knormoyle/rp2040_si5351_wspr/tracker/description.txt

//*******************************************
// Open source c/c++/arduino ide with arduino-pico core allows customization if you have software skills
// Especially useful for adding i2c/onewire sensors and sending results via u4b TELEN encoded telemetry.
// lu7aa website can be enabled to report those. no extra u4b channel reservation needed.

// No auto-calibration of Si5351 Tx frequency (yet?).
// Manual config for passing 'correction" (parts per billion) to Si5351, 
// in case Tx Frequency is outside of U4B channel bin.
// Traquito website can fingerprint callsign/telemetry frequency even if out of bin.
// LU7AA website not so well (although 'wide' helps).
// SDR can be used to report actual TX freq and correction applied to adjust.

// Any correction should be fixed: the same for all bands for a particular tracker.

// No auto-calibration of RP2040 clock frequency
// Manual config for setting rp2040 clock frequency, 115 to 250 Mhz. 115Mhz default
// (could calibrate/adjust with GPS PPS and then calibrate the Si5351 Tx frequency (signals go to RP2040 input)

// Uses unmodified AG6NS 0.4 pcb with alternate assembly bom/cpl (Manfuctured by https://jlcpcb.com)
// that:
// 1) removes low pass Tx filters, 
// 2) depopulates all APRS support on AG6NS 0.4 pcb (or firmware)
// 3) enables differential Tx drive for higher Tx power
// 4) capacitive coupling on Tx to both HF antenna legs, and lighter dc load across legs (larger R)
// 3) optionally populates the Bosch pressure sensor BMP280
// 4) uses the default LDO between solar power and 3V3. AG6NS board uses voltage monitor (resets)
// 5) User config menu over usb serial to config 
// 6) Configurable channel config, and bands 20M/17M/15M/12M/10M supported
// 7) Configurable U4B TELEN support for extra telemetry transmissions (temp/pressure from sensor, or sat counts or ...)
// 8) GPS is powered off during Si5351 Tx (external mosfet)
// 9) Si5351 is powered off during GPS acquistion/tracking (external mosfet)https://github.com/knormoyle/sf-hab_rp2040_picoballoon_tracker_pcb_gen1/blob/main/pcb/tracker/v0.4_kbn/corrected_placement_jlcpcb.png
// 10) clamping of speed/temp/voltage (3-4.95v) telemetry per traquito u4b-like definition.
// 11) compared to traquito: no buck/boost, just LDO. pressure/external temp sensor. Configurable extra telemetry. 
// 12) USB serial for config input and output. No need to modify software for callsign/band etc
// 13) Uses MS5351M instead of Si5351a.  Hans Summers G0UPL did a review here: https://qrp-labs.com/synth/ms5351m.html
// 14) Like traquito will clamp voltage/temp/altitude telemetry to lower/upper bounds. no wraparound. 
// 15) Voltage on tracker will be assumed to be 3.0-4.95 range. clamps to boundaries otherwise
// Optional) enable the 3rd output of si5351 during a calibrate cycle, and use FreqCount library to measure and report frequency.
//     Disable that output after reporting frequency. (one shot). I guess this would be the base HF freq for the band being enabled?
//     Is it just easier/better/more complete to do wspr RF and look on sdr?

/* key parts with jlpcb # (Cxxx)
C90770   ATGM336H-5N31  https://jlcpcb.com/partdetail/Zhongkewei-ATGM336H5N31/C90770  'GNSS Module'
C2040    RP2040         https://jlcpcb.com/partdetail/RaspberryPi-RP2040/C2040
C5446    XC6206P332MR-G https://jlcpcb.com/partdetail/TorexSemicon-XC6206P332MRG/C5446 '200mA Fixed 3.3V 6V Low Drop Out (LDO) Regulator'
C9965    MAX809STRG     https://jlcpcb.com/partdetail/Onsemi-MAX809STRG/C9965 '2.93v 140ms Active Low Supervisor and Reset'
C132296  26Mhz          https://jlcpcb.com/partdetail/KdsDaishinku-1XXB26000MAA/C132296 '1.8V~2.8V ±1.5ppm 26MHz 4P Temperature Compensated Crystal Oscillators (TCXO)' 

C83291   BMP280         https://jlcpcb.com/partdetail/BoschSensortec-BMP280/C83291 'Bosch Digital Pressure Sensor'
or
C92489   BME280         https://jlcpcb.com/partdetail/BoschSensortec-BME280/C92489 'Bosch Temp, Pressure, Humidity Sensor'
C2843335 W25Q16JVUXIQ   https://jlcpcb.com/partdetail/WinbondElec-W25Q16JVUXIQ/C2843335 '3V 16Mbit Serial Flash Memory w Dual/Quad SPI'

C1509083 MS5351M        https://jlcpcb.com/partdetail/Hangzhou_RuimengTech-MS5351M/C1509083 'I2C 200Mhz Clock Generator'
could use si5351a on same footprint

https://www.lcsc.com/datasheet/lcsc_datasheet_2404181014_Hangzhou-Ruimeng-Tech-MS5351M_C1509083.pdf
datasheet above is Mandarin 2023.11.24 11 pages
https://xonstorage.blob.core.windows.net/pdf/ruimeng_ms5351m_apr22_xonlink.pdf
datasheet above is Mandarin 2020.06.25 40 pages ..from http://www.relmon.com
short english datasheet 2021.03.08 10 pages
https://www.qrp-labs.com/images/synth/ms5351m.pdf
(does it draw 8mA more current?)
*/
//*******************************************
// coding style:
// although cpp features are used per arduino, strings are limited to char arrays like c
// google cpplint is used to flag style issues (follows google c++ style rules..
// some allowances like >80 chars/line)
// naming convention for functions/variables is loose/inconsistent 
// (underscore/camel case/capitalization etc)
// There is a single tracker.ino
// to avoid "one big blob" of code, multiple *_function.h and *_function.cpp are used to group
// logical groups of functions. Liberal use of globals, to minimize overall typing. 
// see externs in the *_functions.cpp
// All char arrays have null terminators on values, so they can be easily printed for debug or other.
// Flash is used to store configuration variables, to avoid recompiling firmware.
// config to control whether printf's can send to stdout and verbose levels to control amount of printing
// flight will generally be set to no output to stdout 
// Only the pwm for wspr send is interrupt driven. Careful management of when uart data from gps is unloaded

// recommended .vimrc (or equivalent)
// using tab on keyboard will translate to injecting <space> at 4 char boundaries
// right and left shift to same 4 char boundaries
// no <tab> in files
// .vimrc I use:
// set tabstop=4 softtabstop=0 expandtab shiftwidth=4 smarttab
// set noerrorbells visualbell t_vb=
// autocmd GUIEnter * set visualbell t_vb=
