knormoyle/rp2040_si5351_wspr/tracker/pcb/tracker/v0.4_kbn/gps.png

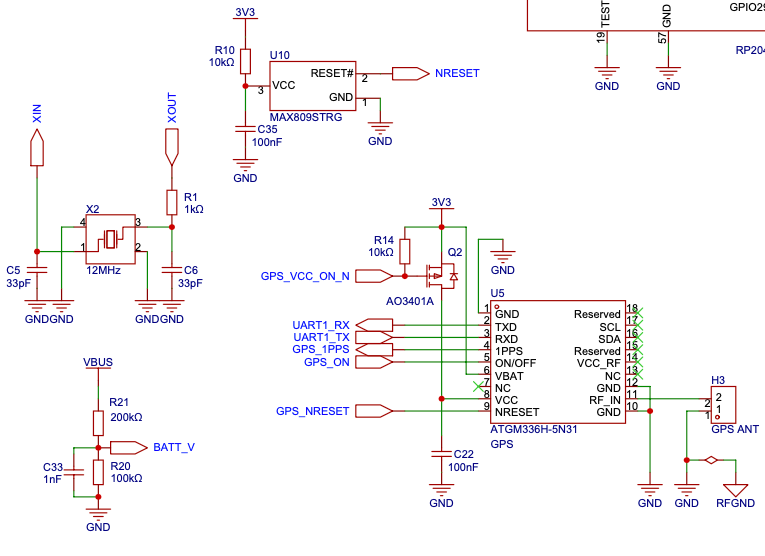
tracker/pcb/tracker/v0.4_kbn/gps.png
