knormoyle/rp2040_si5351_wspr/tracker/pcb/tracker/v0.4_kbn/BOM_Board1_PCB1_2023-09-11_atgm336h-5n31.xlsx

Comment | Designator | Footprint | JLCPCB Part #
22uF | C1 | C0805 | C45783
22uF | C2 | C0603 | C59461
100nF | C3,C4,C10,C11,C12,C13,C14,C15,C16,C17,C18,C19,C22,C23,C34,C35 | C0402_NEW | C1525
33pF | C5,C6 | C0402 | C1562
2.2uF | C7,C8,C9,C26 | C0402 | C12530
1nF | C33 | C0402 | C1523
0Ω | L2,L4 | R0603 | C21189
100nF | L3,L5 | C0603 | C1591
GREEN | LED1 | LED0603-R-RD | C72043
AO3401A | Q1,Q2 | SOT-23_L2.9-W1.3-P1.90-LS2.4-BR | C15127
1kΩ | R1,R17 | R0402 | C11702
3.3kΩ | R2,R3 | R0402 | C25890
10kΩ | R10,R13,R14,R16 | R0402 | C25744
22 | R6,R7 | R0402 | C25092
200Ω | R8 | R0402 | C25087
22kΩ | R11,R12 | R0805 | C25626
6.8kΩ | R18 | R0402 | C25917
100kΩ | R20 | R0402 | C25741
200kΩ | R21 | R0402 | C25764
RP2040 | U1 | LQFN-56_L7.0-W7.0-P0.4-EP | C2040
W25Q16JVUXIQ | U2 | USON-8_L3.0-W2.0-P0.50-BL-EP | C2843335
3.3V LDO | U3 | SOT-23-3_L2.9-W1.6-P1.90-LS2.8-BR | C5446
MS5351M | U4 | MSOP-10_L3.0-W3.0-P0.50-LS5.0-BL | C1509083
ATGM336H-5N31 | U5 | GPSM-SMD_ATGM336H-TR | C90770
MAX809STRG | U10 | SOT-23-3_L2.9-W1.6-P1.90-LS2.8-BR | C9965
Micro-USB Connector | USB1 | MICRO-USB-SMD_10118194-0001LF | C132563
26MHz | X1 | OSC-SMD_4P-L2.5-W2.0-BL | C132296
12MHz | X2 | OSC-SMD_4P-L3.2-W2.5-BL | C9002
