knormoyle/rp2040_si5351_wspr/(list of files, drawings)

Other design files:
tracker/pcb/tracker/v0.4_kbn/AG6NS_PicoBalloon_RP2040_v0.4.eprj
