knormoyle/rp2040_si5351_wspr/tracker/cw_functions.cpp

// Project: https://github.com/knormoyle/rp2040_si5351_wspr
// Distributed with MIT License: http://www.opensource.org/licenses/mit-license.php
// Author/Gather: Kevin Normoyle AD6Z initially 11/2024
// See acknowledgements.txt for the lengthy list of contributions/dependencies.

// forked from https://github.com/prt459/Nano_Beacon/tree/main
// Nano_Beacon 29 Nov 2021 by Paul VK3HN.

// Nano_Beacon -- a basic CW beacon
// See READ.ME at url above for further background and code mod help.
// https://vk3hn.wordpress.com/

// reverse beacon network 10M
// https://www.reversebeacon.net/main.php?zoom=33.57,-97.40,3.05&rows=100&spotters=1&max_age=30,days&bands=10&spotted_call=EA1KT&hide=distance_km

// EA1KT being spotted at 28022.0

// https://groups.io/g/picoballoon/message/19326

#include <stdint.h>

// NOTE! the clock disable mode doesn't work for keying the clk0/1 (ms5351m) ??
// set in tracker.ino
extern bool USE_SI5351A_CLK_POWERDOWN_MODE;

// always integers
const uint8_t DEFAULT_WPM = 12;
uint8_t target_wpm;
uint32_t dit_ms;

const bool DO_WPM_CORRECTION = false;
// this was tested with default 18Mhz sys clk
// actual/target wpm for an unadjusted PARIS 3x test
// shuldn't need correction!
const float DIT_MS_MULTIPLIER = 1.0;

enum test_msg  {
    SEND_PARIS3X = 0,
    SEND_DIT,
    SEND_DIT5,
    SEND_DASH,
    SEND_DASH5,
    SEND_DITDASH,
    SEND_DASHDIT,
    SEND_DASHDIT4,
    SEND_LONGCHAR,
    SEND_BALLOON,
    // SEND_TEST_CYCLE must be last enum
    SEND_TEST_CYCLE
};

// for balloon flight!
const uint8_t test_to_do = SEND_BALLOON;
// for ground level test!
// const uint8_t test_to_do = SEND_TEST_CYCLE;

//********************************
// we the full differential clk0/clk1 set with this
#define CW_CLK_NUM WSPR_TX_CLK_0_NUM

// https://morsecode.world/international/timing.html
#define CW_DAH_LEN 3
#define CW_LETTER_SPACE_LEN 3
#define CW_WORD_SPACE_LEN 7

// number of morse chars on Serial after which we newline
#define SERIAL_LINE_WIDTH 80

// is timing too inaccurate if using sleep (sometimes)
// swith to using the busy_wait_ms
// #define KEYING_DELAY sleep_ms
#define KEYING_DELAY busy_wait_ms

//******************************************
// from hans
// https://groups.io/g/picoballoon/message/19324
// Yet ANOTHER way to do this (CW) is possible, and works without the PLL Reset.
// Register 3 Output Enable Control contains a set of bits, when set to 1,
// it disables the corresponding output.

// So I have discovered that I can key CW by setting these bits to
// 1 for key-up (no output) or 0 for key-down (has output).
// When the output is disabled, it still preserves the proper phase relationship.
// So you can key the CW transmitter WITHOUT those few milliseconds of mess 
// at key-down ..a millisecond or two of the outputs not being both on and
// and not with the correct phase relationship,
// then 1.46 milliseconds of delay while the PLL Reset does its stuff
// PLL reset duration may vary, based on other s5351a config. 

// There are TWO ways to key a clock output on/off:
// Use the "power down" bit in the CLK0 Control and/or CLK1 Control registers
// (16 and 17 respectively).
// This does NOT preserve the inverted (180-degree) phase relationship
// when you re-enable by setting the power down bit to 0;
// hence a PLL Reset is required,

// If you want differential antenna drive (U4B High Power mode).
// Use the Register 3 "Output Enable Control" documented in AN619 at page 17
// https://www.skyworksinc.com/-/media/Skyworks/SL/documents/public/application-notes/AN619.pdf
// This DOES preserve the phase relationships so no PLL reset is required
// when using differential drive.

// OK, official.
// You DO need the PLL Reset, when using the PDN powerdown bit to turn on clk,
// to get the correct 180-degree phase difference,
// even when just using the inverted bit for phase difference.

// Tested using a little U4B BASIC program, and two-channel oscilloscope probes
// attached to each of Clk0 and Clk1 outputs.
// HP set to 1 to cause the inverted drive (high power) mode:
// withPLLReset.png: the standard U4B protection firmware version.
// There is a PLL reset (register 177) after switching on the clock outputs
// via their respective CLK0 Control and CLK1 Control regs: 16 and 17.
// Clk0 and Clk1 have the proper 180-degree phase relationship.

// After commenting out that line of code with the PLL reset,
// I see a random phase relationship between Clk0 and Clk1 on each keydown.
//******************************************

#include <Arduino.h>
#include <Adafruit_SleepyDog.h>  // https://github.com/adafruit/Adafruit_SleepyDog
#include "si5351_functions.h"
#include "print_functions.h"
#include "debug_functions.h"
#include "led_functions.h"
#include "gps_functions.h"
#include "cw_functions.h"
#include "global_structs.h"

//********************************
extern uint32_t XMIT_FREQUENCY;
extern bool VERBY[10];
extern uint32_t PLL_SYS_MHZ;

extern TeleStruct tt;
extern ConfigStruct cc;

// can be 0 1 2 or 3
// should I modify power using these
extern uint8_t SOLAR_SI5351_TX_POWER;

//********************************
// stay in first 91 khz of each cw band for rbn?
// alright if the generated frequency is not exact.
// use whatever denom we have setup for wspr
uint32_t get_cw_freq(char *band) {
    uint32_t cw_freq;
    switch (atoi(band)) {
        case 2:  cw_freq = 144100000; break;
        case 10: cw_freq = 28050100; break;
        case 12: cw_freq = 24935100; break;
        case 15: cw_freq = 21050100; break;
        case 17: cw_freq = 18150100; break;
        case 20: cw_freq = 14050100; break;
        default: cw_freq = 28050100; break;
    }
    V1_printf("get_cw_freq band %s will use cw_freq %lu" EOL, band, cw_freq);
    return cw_freq;
}

//********************************
// morse reference table
struct morse_char_t {
    char ch[7];
};
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
