knormoyle/rp2040_si5351_wspr/(commit log)

2024-11-07 first Arduino IDE 2.3.3 compile success with https://github.com/earlephilhower/arduino-pico core for board manager, using Raspberry Pi Pico board with minimal change for compile (will fully remove AP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
2024-11-07 try moving stuff to gps_functions.h and functions.c from LightAPRS-W-2-pico-balloon.ino
2024-11-08 added led_functions.h led_functions.cpp
2024-11-08 making progress with led_functions* si5351_functions* and had to modify library TinyGPS++.h for public access (see HACK)
2024-11-08 Adafruit sensorr
2024-11-10 correction and tx_high config state
    [config_functions.cpp, gps_functions.cpp, si5351_functions.cpp, tracker.ino, u4b_functions.cpp]
2024-11-11 got rid of telemetry_buff, replaced by individually named strings t_*, holding the captured (all at once) data
    [gps_functions.cpp, mh_functions.cpp, mh_functions.h, tele_functions.cpp, tele_functions.h, tracker.ino, u4b_functions.cpp]
2024-11-12 rearranged description/acknowledgements. added comments about move to bme280 (temp/humidity/pressure)
2024-11-13 working thru compile errors
    [bmp_functions.cpp, config_functions.cpp, debug_functions.cpp, gps_functions.cpp, mh_functions.cpp, si5351_functions.cpp, tele_functions.cpp, tracker.ino]
2024-11-16 gps. not sure if will use the analog correction stuff for adc?
    [adc_functions.cpp, adc_functions.h, gps_functions.cpp, gps_functions.h, tele_functions.cpp, tracker.ino]
2024-11-18 moved Serial.available() handling into core(). none in core1() run at 19200 baud to be able to have shorter duration gps data grab (now 418 ms including extra glonass GLGSV data) can't turn off GNZDA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
    [gps_functions.cpp, tracker.ino]
2024-11-18 nulls in some of the config strings..didn't trigger default settings
    [config_functions.cpp, gps_functions.cpp, tracker.ino]
2024-11-18 get rid of printFLASH use
2024-11-18 no printFLASH fixed t_* prints in tracker.ino
    [config_functions.cpp, tele_functions.cpp, tracker.ino]
2024-11-18 wspr batt voltage compare
2024-11-18 vfo on and i2cReadTest with 'Z'
2024-11-18 latest disabled i2c and si5351 library test
2024-11-20 bus scan. start to read/write i2c. have to fix reads to be write/read for si5351?
    [bmp_functions.cpp, bus_scan.ino, config_functions.cpp, i2c_test.ino]
2024-11-23 intermediate ..use of more stringent 3d fix valid and stuff for pwm timer for wspr delays (single interrupt
    [si5351_functions.cpp, tracker.ino]
2024-11-23 why not getting fix valid for long time. was vfo on?
    [gps_functions.cpp, si5351_functions.cpp, tracker.ino, wspr_functions.cpp]
2024-11-24 make the div and wrap cnt more generic and INTERRUPTS_PER_SYMBOL = 8 now use the new div and wrap values for 125 mhz (assumed clock)
2024-11-24 some tweaks to resetting all gps state and watchdogging for a full 3d fix, not just 2d fix
    [config_functions.cpp, gps_functions.cpp, gps_functions.h, tracker.ino, wspr_functions.cpp, wspr_functions.h]
2024-11-24 getting telemetry. callsign message isn't showing working on seeding the i2c writes before first symbol with clk0/clk1 turned off, then on
2024-11-24 align to two symbol interrupts before the first callsign tx
2024-11-24 why does KE6RAD work but not AD6Z (no sdr print) why does py encode.py AD6Z DM68 13 and py encode.py 'AD6Z ' DM68 1 give different symbol encodings
2024-12-06 Clean up compiler warnings that appeared after use of the V0_print* V1_print* defines interesting the cpp.o and cpp.d files are cached..have to delete them to see the warnings again (since compile is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
    [bmp_functions.cpp, config_functions.cpp, gps_functions.cpp, i2c_functions.cpp, si5351_functions.cpp, tracker.ino, wspr_functions.cpp]
2024-12-06 trying some experimental gps power on sequences (vcc, on/off pins) to see if power on current spike changes
2024-12-06 playing with GPS ON/OFF = off during poweron
2024-12-06 light sleep for 60 secs after gps cold reset. don't wait for proceed for first ssymbol if PLL_SYS_MHZ < 125 (was getting DT 0.7 ?)
    [gps_functions.cpp, tracker.ino]
2024-12-07 playing with some DRASTIC measures in gps_functions.cpp..lowering rp2040 to 18Mhlowering core voltage, shutting usb off (and restoring)..to try to lower power during initial gps cold reset
    [gps_functions.cpp, tracker.ino]
2024-12-07 have a DRASTIC_MODE bool to disable the aggressive power saving stuff at first g ps power on. default. something has gone wonky?
2024-12-07 unwonked it. back to playing with LOWEST_POWER_TURN_ON_MODE. can we really reduce it by 10mA ? bool EXPERIMENTAL_WARM_POWER_ON = true; bool EXPERIMENTAL_COLD_POWER_ON = true; bool LOWEST_POWER_TURN_O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
2024-12-07 IGNORE_KEYBOARD_CHARS global to make sure keyboard activity doesn't interrupt the transitions during the extreme power control during gps cold reset
    [config_functions.cpp, gps_functions.cpp, tracker.ino]
2024-12-07 don't turn on gps on/off unti we're in the lowest power rp2040 (gps cold reset "LOWEST_POWER" mode
    [gps_functions.cpp, tracker.ino]
2024-12-07 gps cleanup (cold reset) restored to 48mhz okay now
    [gps_functions.cpp]
2024-12-07 can't seem to deinit the usb pll without crashing
    [gps_functions.cpp]
2024-12-07 writing GPS config now with my config ..no broadcast at gps power on, also. (keep 9600 baud always now?) also removed core voltage changes..intermittent not coming back? not sure why bool ALLOW_UPDAT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
2024-12-07 change bool ALLOW_UPDATE_GPS_FLASH_MODE = false; so no gps config flash is updated to the no broadcast state. Will have to see if it's worth it Getting peak Iin (total power in) around 80mA @ 3.3v no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
    [gps_functions.cpp]
2024-12-09 18Mhz seems to working for K clock frequency (pll sys), gps nmea okay. kazu slow 12mh clock is working, but disabled right now. wasn't getting gps nmea correctly afterwards
    [config_functions.cpp, gps_functions.cpp, gps_functions.h, tracker.ino]
2024-12-09 12 mhz during gps cold reset, then pll back on to 18Mhz (couldn't get gps serial2 working with 12 mhz XOSC setup. 9600 baud. issues with 4800, but that works. probably needs some tweaking (gps hot re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
    [config_functions.cpp, gps_functions.cpp, tracker.ino, wspr_functions.cpp]
2024-12-09 still problem with non-usb BALLOON_MODE
    [config_functions.cpp, gps_functions.cpp, led_functions.cpp, tracker.ino]
2024-12-09 still some issues detecting serial and balloon mode (usb + data cable, or power only cable)
    [gps_functions.cpp, led_functions.cpp, print_functions.cpp, tracker.ino]
2024-12-09 eliminate garbage chars from Serial when no putty window, but usb data + power
2024-12-09 tried to detect usb connected status, in addition to looking at Serial. but the drain to cr/lf seems good too. seems to do wspr okay with usb cable (power + data) now? led blinking gives more info ab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
    [config_functions.cpp, tracker.ino]
2024-12-09 don't mess with peri/adc/rtc clocks any more during kazu slow mode. just leave them as they are.
2024-12-09 typo that should fix GLONASS constellation
    [gps_functions.cpp]
2024-12-09 enabled some VERBY[2] level microscopying of wspr symbol timing using StampPrintf and associated log print
2024-12-09 a little cleanup around use wsprSleepMillis() and hex printing of sieValue from SIE_STATUS (usb io mapped reg)
2024-12-10 ah. first time 10M works (on SDR). I had forgotten some hardwiring of a 20M freq I adjusted the code for deciding si5351a pll freq. hardwired it a little higher now ..700mhz. Maybe lower is good enou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
2024-12-11 print a 200hz swatch of test calcs for 10M band (for the pll stuff) trying to keep lower pll_freq...lower power?
2024-12-11 tweaking the target si5351a pll target, to get unique pll_num for 1hz sweep thru 200Hz wspr passband on 10M
2024-12-12 tuned nmea buffer overflow messaging (shorter) ..hmm. why was this showing up on 24Mhz?
    [gps_functions.cpp]
2024-12-12 reg 187 (fanout enables) doesn't exist in the 0.95 datasheet for si5351. Although it exists in some AN* pdfs for parts with more outputs. since we were never re-enabling it after disable, remove it (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
    [si5351_functions.cpp]
2024-12-12 board manager screenshot
2024-12-12 some more board screenshots for IDE
2024-12-14 check for illegal hf_grid. reboot on illegal hf_callsign/grid when creating hf_tx_buffer. was coming from TESTMODE issue. TESTMODE prints now (the telemetry sweep values)
    [si5351_functions.cpp, si5351_functions.h, tele_functions.cpp, tracker.ino]
2024-12-15 TESTMODE working better. no reboots
    [tele_functions.cpp]
2024-12-15 draining broken sentence quickly when entering NMEA unload, to avoid unnecessary buffer fifo overrun messages
    [gps_functions.cpp, si5351_functions.cpp]
2024-12-15 tweaking initial fifo management a bit more in updateGpsDataAndTime() to avoid unecessary messaging if close to full on entry
    [debug_functions.cpp, gps_functions.cpp]
2024-12-16 hacked in some public methods for flushing TinyGPS++ date/location state as part of invalidate during warm/cold reset..instead of trying to flip the object state (library modification)
    [gps_functions.cpp, tracker.ino]
2024-12-16 fixed the normal 10 minute scheduling. I had been using go_when_rdy=1 so much, I figured turning that off was simple!. Fixed. 10 minute normal works
    [tracker.ino]
2024-12-17 first working SIM65M. defaults to 115600 baud at startup. but this code changes to the 9600 baud like ATGM336H so we don't get buffer overflow at rp2040 (RTS/CTS hardware flow control not connected?)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
2024-12-18 hopefully this fixes the gps fix time stuff (reset on gps off -> on)
    [gps_functions.cpp, tracker.ino]
2024-12-19 having some random cross-core usage of the '_*' variables that are output from read_FLASH() tried setting them to voltatile (see comments) but _Band and _clock_speed have compile errors if volatile. 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
    [config_functions.cpp, config_functions.h, si5351_functions.cpp, tracker.ino, u4b_functions.cpp]
2024-12-19 don't quality the snapForTelemetry() behavior with fix validity all validity checking is in tracker.ino. avoids the blank issues?
    [tele_functions.cpp]
2024-12-19 made INTERRUPTS_PER_SYMBOL vary according to PLL_SYS_MHZ. only one interrupt per symbol for 18Mhz operation. The slow clock interrupt overhead maybe was messing with things and causing DT to be large?
2024-12-20 pwm the GpsPwr mosfet turnon, also use 2ma drive/slow slew rate on the GpsPwr pin not sure if perfect, seems to not have done any harm just affects gps cold reset
    [gps_functions.cpp]
2024-12-21 removed some of the old unused gps power on mode(s) code
2024-12-21 a little cleanup on the gps power on
2024-12-21 tweaking the gps pwm power on duty cycle management
2024-12-22 renamed all the _x16 stuff to be _x128 to match the current 7 bit shift PLL_CALC_PRECISION
2024-12-23 calculate the actual pll freq and output freq correctly using doubles, after deciding what si5351a values to use
    [si5351_functions.cpp, si5351_functions.h, tracker.ino]
2024-12-25 have some target denoms for 20,17,15,12,10.. 17 was hardest..couldn't find anything. using max 104575 but getting reasonably small shift errors (2Hz absolute)
    [tracker.ino]
2024-12-25 got rid of excessive printing during denominator search algo
    [WSPRDenom-modified.xlsx]
2024-12-25 tweak the printing
2024-12-26 tweaking. separate pages in the xlsx for 10/12/15/17/20M ..2M seems impossible
    [WSPRDenom-modified.xlsx]
2024-12-26 700 mhz pll target, optimal denoms for 10/12/15/17/20M (from spreadsheet) seems good
    [WSPRDenom-modified.xlsx]
2024-12-26 some tweaks. latest spreadsheets with denom work
    [WSPRDenom.xlsx, hans_check.xlsx, wspr_calc_direct_shift.xlsx, wspr_calc_direct_shift_denom.xlsx, wspr_calc_direct_shift_lower_pll_range.xlsx]
2024-12-27 fixing crash in BALLON_MODE. pll_deinit(pll_usb) can't be done in BALLOON_MODE (no usb to start with ?)
    [gps_functions.cpp, tracker.ino]
2024-12-28 detailed cleanup. trying to see if <500 mhz pll target can be made to work
    [wspr_calc_direct_shift_lower_pll_range.xlsx]
2024-12-28 optimal denom for pll 500 (spreadsheet says good for 10/12/15/17/20M)
    [wspr_calc_direct_shift_lower_pll_range.xlsx]
2024-12-28 hmm seems like PLL 500Mhz is the lowest I can go and cover 10M for optimal denom unless I shift to hans denominator-shift method
    [wspr_calc_direct_shift_lower_pll_range.xlsx]
2024-12-29 got the denom-shift-by-1/2/3 with fixed numerator algo working with random search (python) seems to look good in spreadsheet for targeted 416mhz pll (actually gets 390 or so for 10M with good symbol 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
    [WSPRDenom-modified.xlsx]
2024-12-29 switch sim65m navigation mode from default fitness mode to normal mode. I doubt it has much effect, although they say fitness mode changes position better for slow <5m/sec movement?? weird.
2024-12-30 first try at trying to call for solar elevation from snapForTelemetry()
    [gps_functions.cpp, solar_functions.cpp, solar_functions.h, tele_functions.cpp, wspr_functions.cpp]
2024-12-30 get all the t_solar* data into normal snapped telemetry (for easy printing etc)
    [tele_functions.cpp, tracker.ino]
2024-12-30 some tweaks for the solar functions
    [WSPRDenom-modified.xlsx]
2024-12-31 left out short_solarfunctions.cpp ..and a typo
    [solar4_functions.cpp, tele_functions.cpp]
2024-12-31 keep doubles for all the solar elevation/azimuth/distance stuff everywhere chop it to 1 decimal of precision ofr elevation/azimuth in the snapForTelemtry t_* stuff
    standardize on print 7 digits of precision for lat/lon?
    [solar2_functions.cpp, solar2_functions.h, solar4_functions.cpp, solar4_functions.h, solar_functions.cpp, solar_functions.h, tele_functions.cpp, tracker.ino]
2024-12-31 tweaking the solar elevation algo printing
2024-12-31 matching up the posted groups.io t.cpp short_solarfunctions.cpp source files correctly, in case they change used with #include to be consistent for exchanging code with Doug
    [solar2_functions.cpp, solar4_functions.cpp, solar_functions.cpp]
2024-12-31 got rid of solar_functions.cpp and solar_functions.h because it wasn't accurate (code bug?) moved to other_cpp in case of future use. added all the other stuff in other_cpp that might be useful (if n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
    [gps_functions.cpp, solar_functions.cpp, solar_functions.h]
2025-01-01 fixed the config command to reboot to drag and drop uf2 (normally i use the ide to load firmware, but this is useful to avoid tweezer shorting the pcb holes (bootsel/gnd) if you need to force bootloa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
    [config_functions.cpp]
2025-01-01 tweaking some prints and the solar angle calculations (which is only used for info ..but is sent down using the speed field can be disabled (recompile) so normal gps speed is sent but should be inter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
2025-01-01 stop disabling usb pll when usb is connected. (gps cold reset power optimization)...sometimes not coming back (kazu clocks area)...make some more strings F()..chopped down the JTEncode.cpp to only su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
    [config_functions.cpp, debug_functions.cpp, gps_functions.cpp, i2c_functions.cpp, si5351_functions.cpp, solar2_functions.cpp, solar4_functions.cpp, tele_functions.cpp]
2025-01-01 turned the ALLOW_LOWER_CORE_VOLTAGE_MODE (0.95v) ..at 18mhz should be fine. looks like it saves 1mA ?
2025-01-02 first crack at the "morse_also" config that sends a morse cw message (callsign + grid6) after the wspr messages
    [config_functions.cpp, debug_functions.cpp, debug_functions.h, gps_functions.cpp, gps_functions.h, si5351_functions.cpp, si5351_functions.h, solar2_functions.cpp]
2025-01-02 something went wrong with gps summary printing
    [gps_functions.cpp]
2025-01-02 seem to have sorted out my gps stats print. using a 'realPrintFlush()' routine to gather info about usbserial tx buffer size etc.A Got solar5_functions.cpp in there. not printing from it yet (that's 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
2025-01-03 tweaks of realPrintFlush() and now printing from the suncalc algo
2025-01-03 some more printing stuff. didn't have bitwise inversion for the clk en stuff in si5351a_functions.cpp
    [config_functions.cpp, cw_functions.cpp, debug_functions.cpp, si5351_functions.cpp, solar4_functions.h, solar5_functions.cpp, tele_functions.cpp]
2025-01-03 cw with PDN power down bit to control clk0/1 instead of the clk enable bit
2025-01-03 perfect 12wpm timing with multiplier on dot timing from 'PARIS ' 3x timing actual vs target. Switched to my balloon message
2025-01-03 improved prints
2025-01-04 get rid of the ugly code in printInt/printStr/printFloat for gpsDebug by using variables in printf formats. works great. moved to debug_functions.cpp again, hopefully will work now (had removed equat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
2025-01-05 switch to normal balloon cw message
2025-01-05 working in a switch to the Farey algo search for new num/denom rather than fixed magic denom have to add a 4 symbol (hf_freq) cache to the calc routine so we don't iterate all the time in computing n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
    [debug_functions.cpp, farey_functions.cpp, farey_functions.h, gps_functions.cpp, si5351_functions.cpp, si5351_functions.h]
2025-01-06 moved the various sweep test functions into swee_functions.cpp..si5351a_functions.cpp was getting too big
    [sweep_functions.cpp, sweep_functions.h]
2025-01-06 disable the solar_functions.cpp stuff for now (wrong answers) solar2* and solar4* still active. solar5* is the suncalc..not working yet?
    [tele_functions.cpp]
2025-01-06 added a debug function to print the valid entries of the calc cache. will check for any 0s in valid entry also. run at end of every loop1(). should be 4 entries if just wspr. 5 entries if _morse_also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
2025-01-06 seemed to have messed up the si5351a programming. fix it tomorrow
    [si5351_functions.cpp, tracker.ino]
2025-01-06 back to the numerator shift algo but I think I might have figured out the issue with the Farey algo
    [si5351_functions.cpp]
2025-01-06 might be interesting to use arduinomorse to send diagnostic messaging with the leds for more involved messaging cp_libraries.sh is good for setting up libraries in the Arduino dir
2025-01-06 start wspr warmup 20 secs before the min, rather than 30, to account for a > 30 sec cw message. might help in less missed starts when send_when_rdy config is enabled. plus easier understanding for 40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
    [tracker.ino]
2025-01-06 images for putty sessions. some EOL cleanup in prints
2025-01-07 clean up some prints
2025-01-07 switched to uint64_t for freq_128 to allow a bigger PLL_CALC_SHIFT than 7, to improve precision and not lose bits Using a PLL_CALC_SHIFT of 16 with uint64_t and making sure the pll_remain doesn't los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
    [si5351_functions.cpp, si5351_functions.h, sweep_functions.cpp, tracker.ino]
2025-01-07 tweaks to printing
2025-01-07 switched back to 500 mhz pll
2025-01-07 weird issues with ms_div divide
    [si5351_functions.cpp, tracker.ino]
2025-01-08 I only had one function that returned uint64_t. I think occasionly it would just return the upper 32 bits?
    freq_xxx = calcSymbolFreq_xxx(xmit_freq, symbol);
    I just changed it to pass a pointer as the first arg instead. seems more reliable and not-unique-behavior
    Showed up when I was doing larger PLL_CALC_SHIFT values
    [WSPRDenom-modified.xlsx]
2025-01-08 400Mhz PLL, 10M band, 16 bit scaled-integer-shift. Does it relate to 52 bits of mantissa in the double real as input to Farey? seems like this works, with small enough error
    [config_functions.cpp, si5351_functions.cpp, sweep_functions.cpp, tracker.ino, u4b_functions.cpp, u4b_functions.h]
2025-01-08 New versions of libaries. Put the crystal capacitance back to 7pf seems better than default 10
2025-01-09 650Mhz pll target freq. got 618.7Mhz on 10M. very low errros symbolAbsoluteError: 0.000003 Hz symbolShiftError: 0.000006 Hz
2025-01-09 playing with pll freqs. Got rid of the wsjt-x 14MDA LR90 30 problem with wsjtx and symbol freq cycling during warmup
    [si5351_functions.cpp, si5351_functions.h, tracker.ino]
2025-01-09 back to 600Mhz. phase noise?
    [tracker.ino]
2025-01-10 changed the two libraries I modified to have *_mod suffix, so new updates to those libraries won't overwrite in ide. had a long debug trying to figure out why my num/denom was only changing two symbo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
    [cw_functions.cpp, gps_functions.cpp, si5351_functions.cpp, si5351_functions.h, tracker.ino]
2025-01-10 adding 2 as band option. Going to see if I Farey algo will work on 2M for wspr shift frequencies. Added separate band control for cw. had wspr alignment wrong for go_when_ready..was trying to have mo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
    [config_functions.cpp, cw_functions.cpp, si5351_functions.cpp, sweep_functions.cpp, tracker.ino, u4b_functions.cpp]
2025-01-10 put the bones in (configuration, detection, globals etc) for detection solar elevation maximums, earliest, afternoon, morning..configuration for adjusting tx power based on solar elevation (from gps 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
2025-01-10 updated prints on solar elevation transitions
2025-01-10 tweaks on the dynamic solar tx power tracking
2025-01-10 qualify the solar calcs with gps validity info, just in case
2025-01-11 dynamic solar tx power
2025-01-11 back the way it was (using pll reset on every freq change plus clk disable/enable
    [si5351_functions.cpp]
2025-01-12 make the PLL_FREQ_TARGET unique per band (to get lowest error or solution, like for 2M)
    [si5351_functions.cpp, si5351_functions.h, sweep_functions.cpp, tele_functions.cpp, tracker.ino]
2025-01-13 put ERROR: in the error messages when the config is validated, so they'll grep ERROR putty.log
    [config_functions.cpp, si5351_functions.cpp]
2025-01-17 Had broken the telemetry alignment relative to callsign when I was playing with some clock off stuff between wspr messages (currently don't turn clock off between wspr messages). The net effect was t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
    [tele_functions.cpp, tracker.ino]
2025-01-17 seems like if we use Farey we always need pll reset? otherwise some frequencies (2 out of 4) don't seem to work I had thought I could just look for cases where denom changes, but apparently that does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
    [si5351_functions.cpp]
2025-01-17 I got nervous the wspr symbols were sounding different. Changed the Z test to do the 4 symbol frequencies sequentially for 15 secs each, for easier listening changed the pll target freqs to 600. now 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
    [config_functions.cpp, si5351_functions.cpp, tracker.ino, wspr_functions.cpp]
2025-01-17 sounds cleaner with less pop on transitions, if use numerator shift algo. Apparently it works without pll reset on the numerator-only shift, so that's probably a good thing. (I'm pretty sure I needed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
    [si5351_functions.cpp]
2025-01-17 still trying to fully understand the clk disable/enable bit. Seems like the enable is required, but disable doesn't turn off the clock
    [si5351_functions.cpp, tracker.ino]
2025-01-17 still trying to fully understand the clk disable/enable bit. Seems like the enable is required, but disable doesn't turn off the cl ock. minimizing the amount of time I write the clk enable
    [tracker.ino]
2025-01-17 Made the GpsWarmReset() more closely parallel the behavior of GpsFullColdReset() ..mainly doing pwmGpsPwrOn() to pwm the mosfet gate turn on ..weird that it seemed like Dave had a failed gps warm pow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
    [gps_functions.cpp, si5351_functions.cpp]
2025-01-18 shorten the GpsWatchdogCnt limit before full cold reset some print tweaks
    [gps_functions.cpp, si5351_functions.cpp, tracker.ino]
2025-01-18 try to show any of the initial chars out of gps after reset. Probably should wait for some?
    [gps_functions.cpp]
2025-01-18 just noticed i had pasted comments from a javascript convert into the .cpp. put them in the right file instead. The xlsx were just background research stuff.
    [wspr_calc_direct_shift.xlsx, wspr_calc_direct_shift_lower_pll_range.xlsx]
2025-01-18 Did some cpplint on short_solarfunctions.cpp (the one used in-flight) and changed longs to uint64_t to be clear
    [solar4_functions.cpp, solar5_functions.cpp]
2025-01-19 tinygps_functions* stuff compiles now. Should just be printing right now. Haven't incorporated the Extended Telemetry tx'ing stuff yet
2025-01-20 first cut at encoding some extended telemetry. compiles
2025-01-21 added a gps warm reset loop test. seems okay
    [config_functions.cpp, config_functions.h, debug_functions.cpp, debug_functions.h, gps_functions.cpp, time_functions.cpp, time_functions.h, tinygps_functions.cpp]
2025-01-22 Make a one stop solar4Position() function, for other_cpp/short_solarfunctions.cpp
    [solar4_functions.cpp, tinygps_functions.cpp, tracker.ino]
2025-01-25 a subtle issue in putting Extended Telemetry into a string
    [doug_functions.cpp, doug_functions.h, si5351_functions.cpp, tele_functions.cpp, tracker.ino]
2025-01-27 report solarElevation*2 (so above 41 deg will flatline to 41 deg). also make both normal gps speed telemetry and solarElevation*2 round better, reflecting the steps of 2. (want to round to 2). some o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
2025-01-30 got rid of the pwm on the mosfet gate voltage for gps turn on (both warm and cold reset) could this have been getting Dave into a state where gps cold reset didn't recover from a failed gps warm rese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
    [gps_functions.cpp]
2025-01-30 Bill WB8ELK has provided some audio recordings of cw from AD6Z-23 flight near US/Mexico border using web sdrs. He thinks I'm losing some dits. Change from using sleep function for keying delays to th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
2025-02-03 remove overflow'ed field on extended telemetry. Fix slot 3 (not slot 4) for encode
    [config_functions.cpp, doug_functions.cpp, tracker.ino]
2025-02-04 change ET slot to 2, counts 0,1,2,3,4
2025-02-05 some tweaks to delays in gps warm/cold reset. added 868864 Feb 4 18:35 tracker.ino.uf2 can drag/drop this uf2 after shorting the bootsel/gnd thru holes while powered down, then power up
    [gps_functions.cpp]
2025-02-05 just clarifying some print comments
2025-02-05 make sure 1 sec between any Serial2.end() and another Serial2.begin() (rp2040 uart to gps)
2025-02-05 if the duration of updateGpsDataAndTime is too short (<100 ms) randomize the delay befor calling it again in sleepSeconds() we may just be discarding stuff each time, and never getting properly align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
    [gps_functions.cpp, gps_functions.h, tracker.ino]
2025-02-05 just a printing thing. make duration_millis print as 0 when no chars are received in the SIM65M case. I guess can show up with ATGM336H, but less common because broadcast rate is 1 sec, not 5 sec
2025-02-06 clean up a wrong print format, and get rid of a compiler warning
    [debug_functions.cpp, tracker.ino]
2025-02-06 another print format compiler warning fix
    [si5351_functions.cpp]
2025-02-07 get rid of the noprint stuff when getting data from gps chip look for positive affirmation of some chars ($ for nmea sentences) after gps warm reset and cold reset. retry up to 5 times if reset didn'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
    [gps_functions.cpp, gps_functions.h, tracker.ino]
2025-02-07 SIMCOM didn't document navigation modes 3 (balloon mode) or 5 (drone mode) apparently there may be a 10km altitude limit for all modes other than balloon mode, according to the locosys spec sheet for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
    [gps_functions.cpp]
2025-02-07 get rid of the unnecessary V1_flush() (usb serial print flush) in the gps data loop. no normal prints there
2025-02-08 allow lots of garbage chars while looking for the 2 '$' after a cold/warm reset..can be over 200! also, get rid of excessive warns about the chars in fifo during updateGpsDataAndTime...print warn on 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
    [gps_functions.cpp]
2025-02-08 print out the duration time (millis) for gps warm and cold reset (full duration) maybe we shouldn't redo as much configuration for gps warm reset, since it should be unnecessary? not clear there's a 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
    [gps_functions.cpp]
2025-02-09 Trying to get perfection for what chars are sent to TinyGPS, so no checksum errors. Needs to be two steps at first for fifo handling: 1) If the fifo is full, chars could have been lost. So the whole 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
    [gps_functions.cpp]
2025-02-09 clean up some print EOL stuff
2025-02-09 tweak some prints
2025-02-09 better way to handle the "aligned" step. always print (good for debug) but only send to TinyGps if we had gotten aligned. Fine to count chars while not aligned for statistics. And consume time elapse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
2025-02-09 insidious bug with JTEncode reported by KC3LBR. They walk 0-12 in the callsign char array. So I declare it size 14 to accomodate null term. And use snprintf with %-s to pad on right with spaces (hf_c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
    [doug_functions.cpp, gps_functions.cpp, tracker.ino, u4b_functions.cpp]
2025-02-09 oops. subtle bug where I used sizeof() when I shouldn't have with snprintf (telemetry)
    [u4b_functions.cpp]
2025-02-09 Don't reconfigure gps during warm reset unnecessarily. speeds up gps warm reset takes 17.6 secs now on SIM65M. Probably could tweak some more, but this is good probably a little faster on ATGM336H.
    [gps_functions.cpp]
2025-02-10 for SIM65M only, we had reduced the NMEA broadcast to once per 5 secs to try to save power. To make sure we align to get full burst, change the GPS_WAIT_FOR_NMEA_BURST_MAX to 5500 millis (config_func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
2025-02-10 allow update of rtc time (setTime()) as long as the gps.time.age() (fix_age) is no bigger than 500ms used to constrain to 300 ms, but because of the bursting of NMEA sentences, we could have fewer op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
    [gps_functions.cpp]
2025-02-10 overhaul setting time from gps. Move the time update as close as possible to when the time NMEA sentence arrives. Only update time if needed, every 30 secs, print messages showing system time and gps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
    [debug_functions.cpp, gps_functions.cpp, gps_functions.h]
2025-02-11 updated secondDelta drift count to deal with minute transitions, hour transitions, day transitions. so there will be an inaccurate print possible with month or year transitions but that's okay ..not 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
    [debug_functions.cpp, gps_functions.cpp]
2025-02-11 fix a couple things with the secondDelta reporting. also it won't report on the first set, so there won't be any false ERROR prints
    [config_functions.cpp, cw_functions.cpp, debug_functions.cpp, gps_functions.cpp, gps_functions.h, tracker.ino]
2025-02-12 I think I went back to not doing the 1 sec step. SDR prints look good with this (less than 1.0)
2025-02-12 add files for pcb
    [AG6NS_PicoBalloon_RP2040_v0.4.eprj, BOM_Board1_PCB1_2023-09-11.xlsx, BOM_Board1_PCB1_2023-09-11_atgm336h-5n31.xlsx, BOM_Board1_PCB1_2023-09-11_kbn.xlsx, BOM_Board1_PCB1_2023-09-11_kbn2.xlsx, BOM_Board1_PCB1_2023-09-11_kbn3.xlsx, BOM_Board1_PCB1_2023-09-11_sim65.xlsx, PickAndPlace_PCB1_2023-09-11.xlsx]
2025-02-12 overnight run with ATGM336H and gps-only sats, had no ERRORs on time drift or other errors. Switching back to gps+beidou+glonass to see if maybe glonass is causing time sync issues?
    [gps_functions.cpp]
2025-02-13 increase the "quiet" time after a gps time update to 3x the nmea burst interval waiting period. no need to have back to back updates. Is it causing a problem somehow?
    [gps_functions.cpp]
2025-02-13 Doing a little trick in the Time library to compensate for the latency in getting gps nmea sentence for time...it should be relatively constant delay, so a fixed offset to help align system time and 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
    [gps_functions.cpp]
2025-02-13 added new config for changing the constellation group used (valid combos from 1 to 7. 7 is gps+bdu+glo. 3 is gps+bud. 1 is gps only. Wondering whether glonass is messing up time sync. Also, I hadn't 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
    [config_functions.cpp, cw_functions.cpp, debug_functions.cpp, global_structs.h, gps_functions.cpp, gps_functions.h, tele_functions.cpp, tinygps_functions.cpp]
2025-02-13 mostly lint and adjusting of various print messages, tuning the forceUpdate (gps to system time) condition
2025-02-13 create simple pps rise detection (irq) to log when the edge happens with millis() ..then we can report the skew from the aligned 1 sec interval in gps chip to when we decide to setTime() and see if i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
2025-02-14 changed Time library to Time_mod because I had editted it a lot remember to remove link or copy of Time library in Arduino libries if you're compiling and create new link to Time_mod. A git pull will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
2025-02-15 have fastest possible reaction to GNGGA now (have to wait for checksum/time commit) and adjusted *EXTRA* millis to align to 1-sec-in..result looks like DT==0 for ATGM336H and SIM65M
2025-02-15 some reporting on the micros() and millis() durations for PPS edge to edge timeing, to check rp2040 timing accuracy relative to PPS transitions.
2025-02-15 tweaks to PPS related info printing. Try to disable when it's none GPS has been off for a while..so PPS isn't available or stable.
2025-02-15 remove excessive edge to edge interrupt printing (can break up other print lines)
2025-02-16 put in 200 prints of per sec usecs() count (using PPS) ..interesting to see how fast or slow per second
2025-02-16 typo: printed should be static int
2025-02-17 print update
2025-02-17 if I decide the gps date/time is 'bad' ..still use it on forceUpdate (just in case my determination was wrong)
    [gps_functions.cpp, tracker.ino]
2025-02-17 tweaks and print updates
2025-02-18 I guess the PPS config for SIM65M is good with the default...don't need to program during gps warm/cold reset
    [gps_functions.cpp, pps_functions.cpp]
2025-02-18 Using PPS is tricky since it takes time to stabilize for accuracy and we're turning gps power on/off when we wspr tx. count PPS transitions when PPS is enabled (gps on)...wait for 30 PPS transitions 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
    [gps_functions.cpp, pps_functions.cpp, pps_functions.h, tracker.ino]
2025-02-18 update with setTime() every valid time, not just if gps/system time disagree. to align with millis() ..should only happen once per nmea burst, max (1 per sec)
2025-02-20 decided to not ever use the GGA time if it has thousandths. the PPS skew tends to be high. better to wait til we get a fix and thousandths is 0 (same every 1 sec broadcast)
    [gps_functions.cpp]
2025-02-24 added support for BMP280 pressure/temperature/altitude reads, with Extended Telemetry for pressure configurable using 'T' (can be sent after the sat count Extended Telemetry or instead of.
2025-02-24 Have to get rid of Galileo sats for SIM65M. Just too much characters at 9600 baud to complete in < 1sec. Also got rip of GNGSA (active sats). When 4 constellations report there are 4 GNGSA sentences.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
    [doug_functions.cpp, gps_functions.cpp]
2025-04-26 was seeing some altitude=0 tx for the ATGM336H flight AD6Z-26. don't update tt.altitude if altitude = 0 (not sure why that would occur). Added tinygps flush methods for altitude and speed. and use al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
    [debug_functions.cpp, gps_functions.cpp, tele_functions.cpp, tracker.ino]
2025-04-30 get rid of unnecessary bom/place files. update atgm336h file to 180 rotation for U5 gps chip
    [BOM_Board1_PCB1_2023-09-11.xlsx, BOM_Board1_PCB1_2023-09-11_kbn.xlsx, BOM_Board1_PCB1_2023-09-11_kbn2.xlsx, BOM_Board1_PCB1_2023-09-11_kbn3.xlsx, PickAndPlace_PCB1_2023-09-11.xlsx, PickAndPlace_PCB1_2023-09-11_atgm336h-5n31.xlsx, PickAndPlace_PCB1_2023-09-11_kbn.xlsx, PickAndPlace_PCB1_2023-09-11_kbn2.xlsx]
2025-05-01 just current uf2
2025-05-04 change factory reset constellation group to 3 (GPS+Beidou)
    [config_functions.cpp]
2025-06-24 some change to defines for si5351 regs. fix compile problem on the grid4 in cw message
    [cw_functions.cpp, si5351_functions.cpp, si5351_functions.h, tracker.ino]
2025-06-24 adjust base freq target -15 hz to do better job centering in 10m bins
2025-07-11 stupid SIM65M-CB parts I got instead of SIM65M are Beidou only and can only do 1115200 baud (can't slow down to 9600) ..get rx fifo overflow. SIM65M-CB spec is only available at cn.simcom.com ..not o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
2025-07-15 added WsprEncoded from knormoyle github. Should be 4.3.2 as it was the 4.3.2 arduino library manager version
2025-09-01 had problem with factory reset on a new batch of sim65m boards. added the safe_execute back in when erase/write flash
    [config_functions.cpp, si5351_functions.cpp]
2026-03-08 added changes for 6m band support also got rid of a Serial.End() that seemed to abort things now with new ide? will have to see if ALLOW_USB_DISABLE_MODE might work during test didn't test with sdr y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
    [wspr_calc_direct_shift.xlsx]
2026-03-23 make Y and W commands using the normal gps cold reset and gps warm reset in a loop for testing update the gps debug print to include FixMode and FixQuality from TinyGPS++ -- Sats HDOP Latitude Longit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
    I should probably include FixMode and FixQuality in the big "valid fix" "fix_valid_all =" statement that's in a couple of places
    To make sure it's a valid 3d fix? right now I look for sats 3 more (used)
    Should probably add the HDOP, PDOP, VDOP and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
    [config_functions.cpp, config_functions.h, debug_functions.cpp, debug_functions.h, gps_functions.cpp, tracker.ino]
2026-03-26 i'm really doing gps hot start with backup power. changed warm names to hot. added test for 'H' gps hot reset. 'W' currently does hot reset. no real warm reset, except when hot doesn't get sentences 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
    [config_functions.cpp, gps_functions.cpp, gps_functions.h, tracker.ino]
2026-03-26 change the fix detection on the gps test loops (not the main tracker.ino (yet) ..to look for 5 or more sats used, to see effect on accuracy (variance)
    [debug_functions.cpp]
2026-03-30 changed default config to constellation group 7 (BDS + GPS + GLS) add FixMode and FixQual strings to the snapForTelemetry. not used yet for anything other than print
    [config_functions.cpp, global_structs.h, gps_functions.cpp, tele_functions.cpp, tracker.ino]
2026-04-29 updated TinyGPS to detect single constellation BD sentences_ add more gpsDebug prints during gps test loop some code optimization in gps_functions.cpp and change ATGM366 broadcast rate to 5secs (mayb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
    [config_functions.cpp, debug_functions.cpp, gps_functions.cpp, tele_functions.cpp, tinygps_functions.cpp, tracker.ino]
2026-04-30 updated kazuClocksSlow and kazuClocksRestore so we can be in 12mhz while bringing gps chip up (power spike?) assumes we are 18mhz (or more) before and after that
2026-04-30 cleaned up voltage reduce/restore during slow_clock_functions power reduce while gps turns on will leave it running at 0.95v (if allowed) if 18Mhz.
2026-04-30 had some problems with flash erase code. Also changed flash offset to allow for larger program. Will have to redo all config in flash some tweaks to setting gps baud rate for sim65m/atgm336
    [config_functions.cpp, gps_functions.cpp, tracker.ino]
2026-05-01 some refactoring of TinyGPS FixMode and gps testing loop
    [debug_functions.cpp, debug_functions.h, gps_functions.cpp, tele_functions.cpp, tracker.ino]
2026-05-01 first build with new WsprEncoded_CT library to get extra bits in CT telemetry from WsprEncoded simplified, classes and inheritance, but no templates or STL compiles and runs. no CT tried yet. Have to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
2026-05-01 tweaks to WsprEncoded_CT. fails WsprEncoded_CT smoke test in library test dir
    [ct_functions.cpp, gps_functions.cpp]
2026-05-02 passes the smoketest after some WsprEncoded_CT problems fixed runs as tracker without ERROR adding CT fields?
    [ct_functions.cpp]
2026-08-28 some cleanup in gps_functions..also some clk skew drift adjustment fixes
    [gps_functions.cpp, gps_functions.h, tele_functions.cpp]
